samuelwg/LIFSrProj_W15/README.md

**Repository for Senior Project ECEn 490 Section 5, Winter 2015 Semester, BYU**
