samuelwg/LIFSrProj_W15/Analog/MATLAB Files/Matlab/2ndBoard/BPassZI.bmp

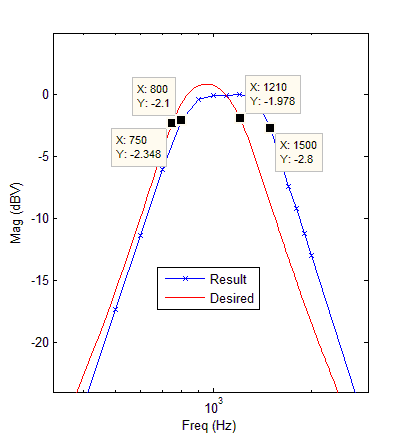
Analog/MATLAB Files/Matlab/2ndBoard/BPassZI.bmp
