samuelwg/LIFSrProj_W15/Analog/MATLAB Files/Matlab/2ndBoard/BPassZO.bmp

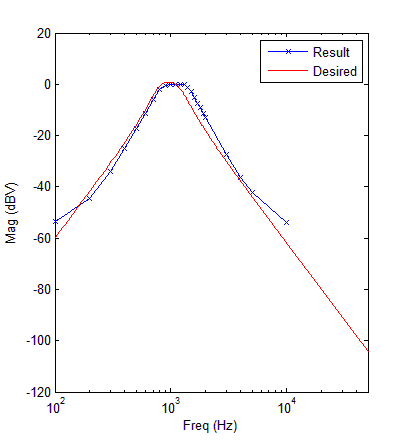
Analog/MATLAB Files/Matlab/2ndBoard/BPassZO.bmp
