samuelwg/LIFSrProj_W15/Analog/MATLAB Files/Matlab/2ndBoard/BPv2ZO.bmp

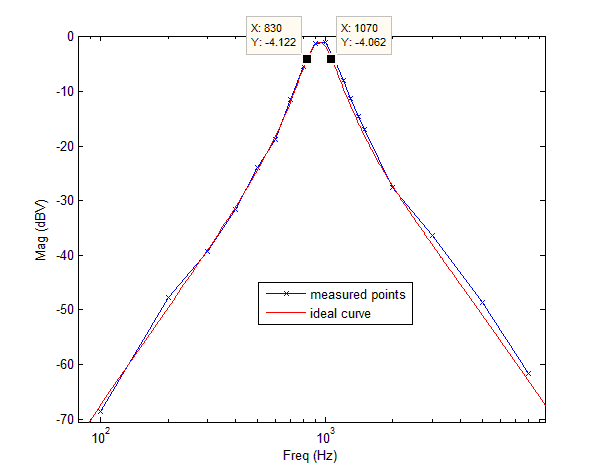
Analog/MATLAB Files/Matlab/2ndBoard/BPv2ZO.bmp
