samuelwg/LIFSrProj_W15/Analog/MATLAB Files/Matlab/2ndBoard/HighPassZI.bmp

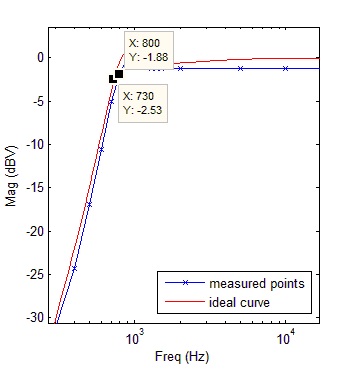
Analog/MATLAB Files/Matlab/2ndBoard/HighPassZI.bmp
