samuelwg/LIFSrProj_W15/Analog/MATLAB Files/Matlab/2ndBoard/HighPassZO.bmp

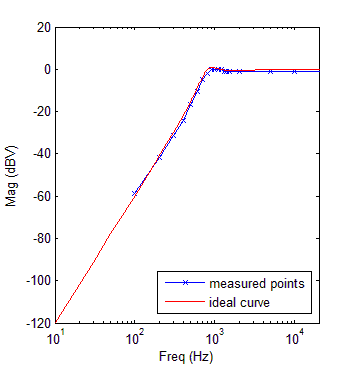
Analog/MATLAB Files/Matlab/2ndBoard/HighPassZO.bmp
