samuelwg/LIFSrProj_W15/Analog/MATLAB Files/Matlab/2ndBoard/LowPassZI.bmp

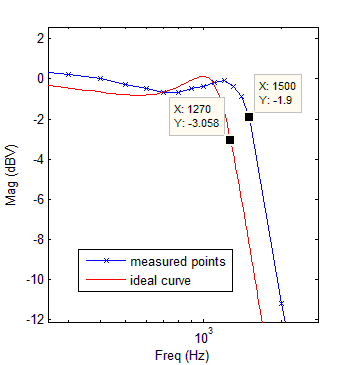
Analog/MATLAB Files/Matlab/2ndBoard/LowPassZI.bmp
