samuelwg/LIFSrProj_W15/Analog/MATLAB Files/Matlab/2ndBoard/LowPassZO.bmp

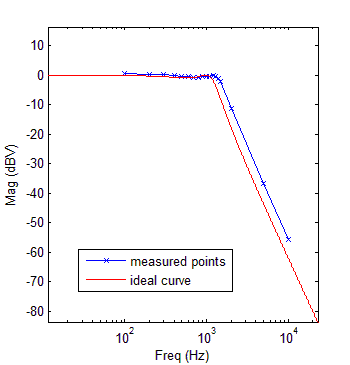
Analog/MATLAB Files/Matlab/2ndBoard/LowPassZO.bmp
