samuelwg/LIFSrProj_W15/Analog/Misc./Pictures/AmpBode.JPG

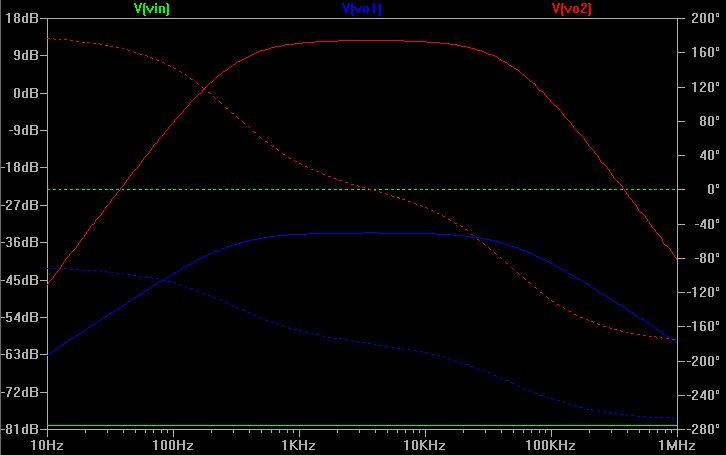
Analog/Misc./Pictures/AmpBode.JPG
