samuelwg/LIFSrProj_W15/Analog/Misc./Pictures/AmpSch.JPG

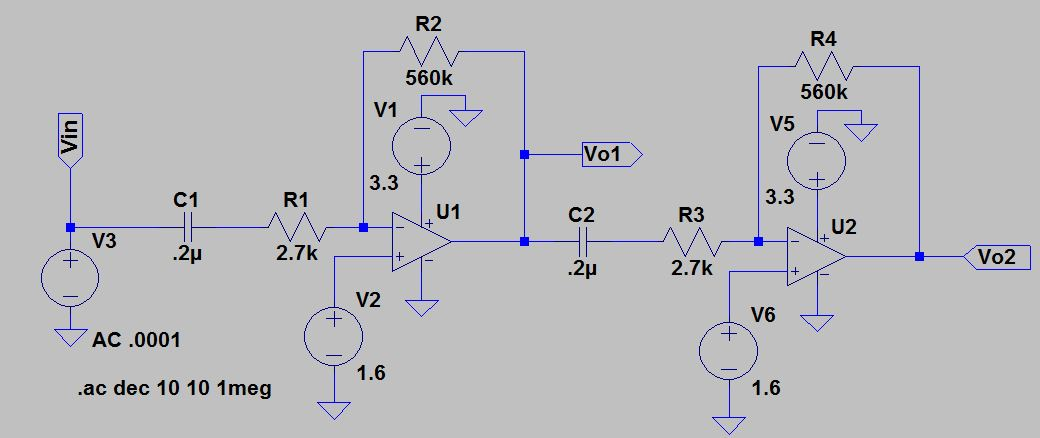
Analog/Misc./Pictures/AmpSch.JPG
