samuelwg/LIFSrProj_W15/Analog/Misc./Pictures/Design Pics/SallenBode.JPG

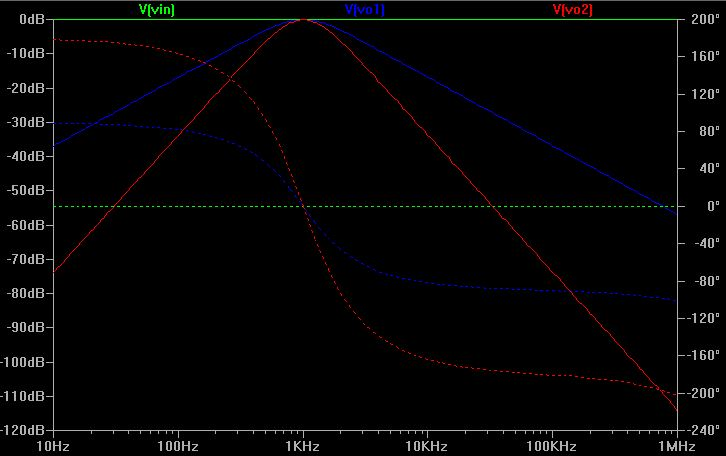
Analog/Misc./Pictures/Design Pics/SallenBode.JPG
