samuelwg/LIFSrProj_W15/Analog/Misc./Pictures/Design Pics/SallenSch.JPG

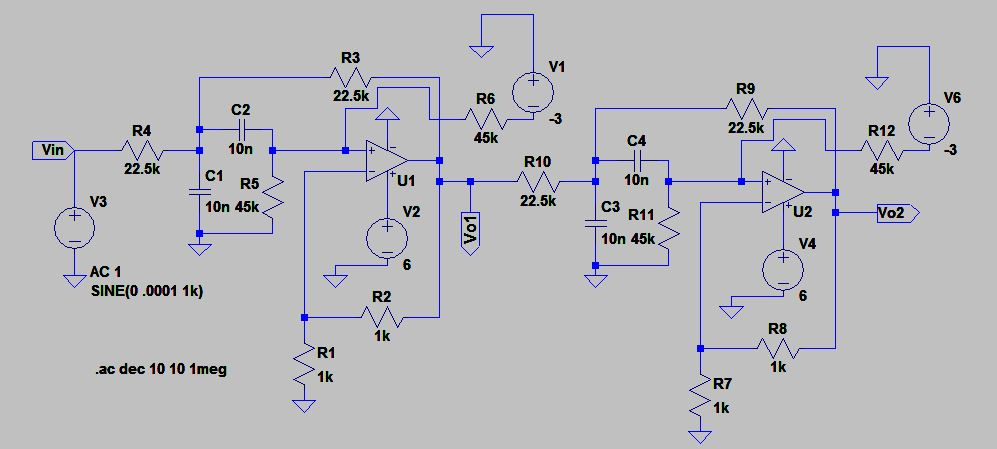
Analog/Misc./Pictures/Design Pics/SallenSch.JPG
