samuelwg/LIFSrProj_W15/Analog/Misc./Pictures/Design Pics/TotalBode.JPG

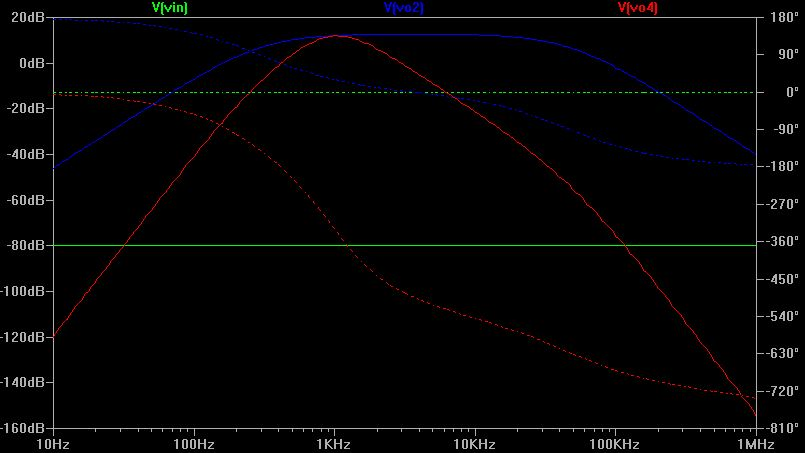
Analog/Misc./Pictures/Design Pics/TotalBode.JPG
