samuelwg/LIFSrProj_W15/Analog/Misc./Pictures/Design Pics/TotalSch.JPG

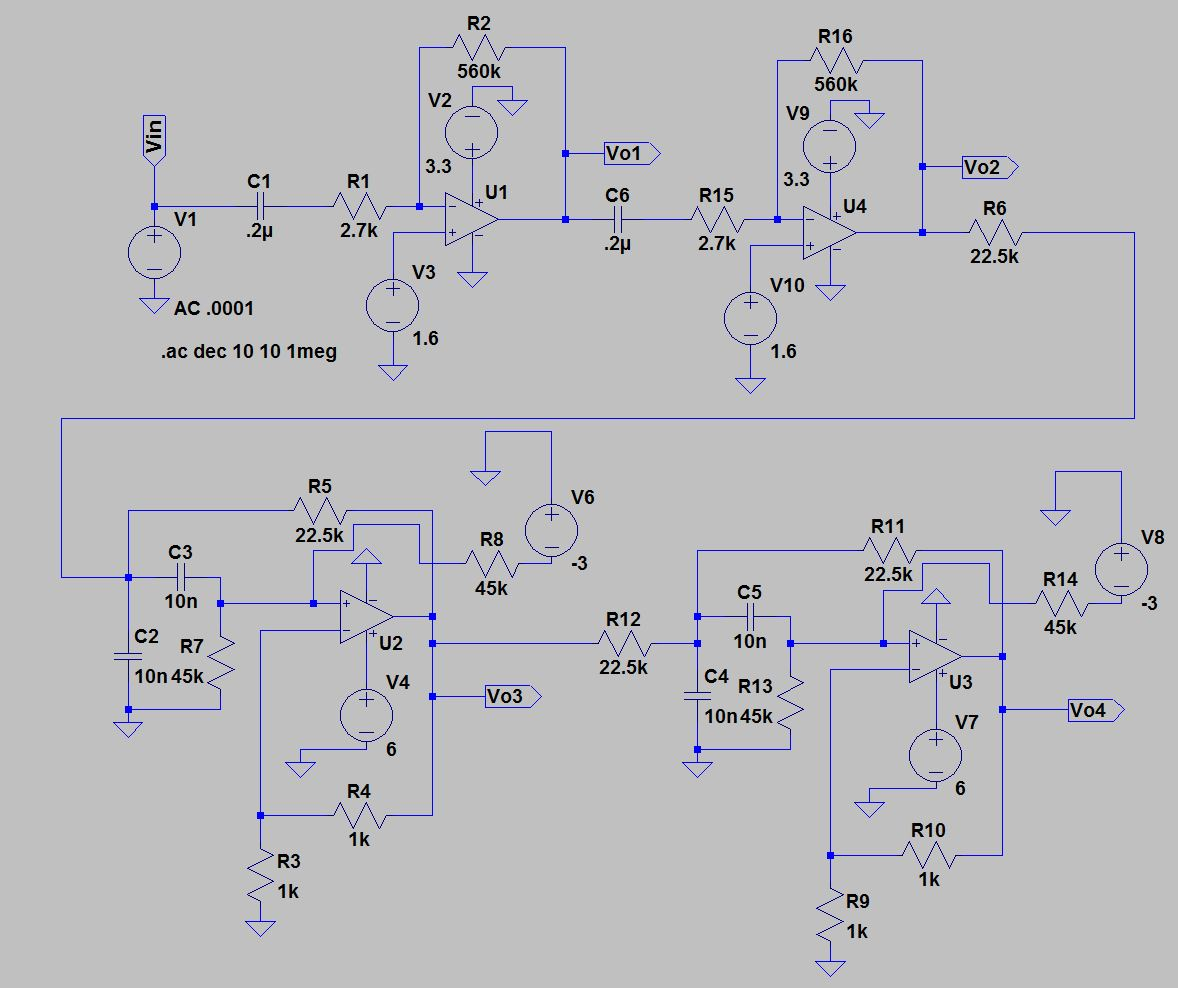
Analog/Misc./Pictures/Design Pics/TotalSch.JPG
