samuelwg/LIFSrProj_W15/XYZ_control/XYZ_board/XYZboard_BOM.xls

Reference | Value | Count | Cost/item | Cost/board | Name | Manufacture Part # | Digikey Part # | URL
C2, C4-C12, C16-21 | .1uF | 16 | 0.0956 | 1.5296 | CAP CER 0.1UF 100V 10% X7R 0603 | CC0603KRX7R0BB104 | 311-1523-1-ND | http://www.digikey.com/product-detail/en/CC0603KRX7R0BB104/311-1523-1-ND/3476112
C13-15 | .22uF | 3 | 0.11 | 0.33 | CAP CER 0.22UF 50V Y5V 0603 | CL10F224ZB8NNNC | 1276-2367-1-ND | http://www.digikey.com/product-detail/en/CL10F224ZB8NNNC/1276-2367-1-ND/3890453
C3 | 1uF | 1 | 0.1 | 0.1 | CAP CER 1UF 10V Y5V 0603 | CL10F105ZP8NNNC | 1276-1041-1-ND | http://www.digikey.com/product-detail/en/CL10F105ZP8NNNC/1276-1041-1-ND/3889127
C1 | 47uF | 1 | 0.64 | 0.64 | CAP ALUM 47UF 50V 20% SMD | EEE-1HA470XP | PCE3929CT-ND | http://www.digikey.com/product-detail/en/EEE-1HA470XP/PCE3929CT-ND/766305
D1 | Diode 3A | 1 | 0.55 | 0.55 | DIODE SCHOTTKY 3A 40V SMA | SD2010S040S3R0 | 478-7814-1-ND | http://www.digikey.com/product-detail/en/SD2010S040S3R0/478-7814-1-ND/3749535
LED1 | PWR LED | 1 | 0.08 | 0.08 | LED CHIPLED 570NM GREEN 0805 SMD | LG R971-KN-1 | 475-1410-1-ND | http://www.digikey.com/product-detail/en/LG%20R971-KN-1/475-1410-1-ND/1802598
J1, J10, J15 | DB9_connector | 3 | 0.77 | 2.31 | CONN D-SUB MALE 9POS R/A .318 | A-DS-09-A/KG-T2S | AE10968-ND | http://www.digikey.com/product-detail/en/A-DS-09-A%2FKG-T2S/AE10968-ND/1241804
J2-5, J9, J11-14 | 2 pin header | 9 |  | 0
J6, J7, J8 | 6 pin header | 3 |  | 0
RA1-6 | 20k x4 | 6 | 0.068 | 0.408 | RES ARRAY 20K OHM 4 RES 1206 | CAT16-203J4LF | CAT16-203J4LFCT-ND | http://www.digikey.com/product-detail/en/CAT16-203J4LF/CAT16-203J4LFCT-ND/3741147
R10-15 | 0.11 | 6 | 0.52 | 3.12 | RES SMD 0.11 OHM 1% 1/2W 1206 | 2-2176055-6 | A109646CT-ND | http://www.digikey.com/product-detail/en/2-2176055-6/A109646CT-ND/4032412
R16-18 | 20k | 3 | 0.04 | 0.12 | RES SMD 20K OHM 5% 1/10W 0603 | CRCW060320K0JNEA | 541-20KGCT-ND | http://www.digikey.com/product-detail/en/CRCW060320K0JNEA/541-20KGCT-ND/1179400
R19-21 | 2.49k | 3 | 0.22 | 0.66 | RES SMD 2.49K OHM 0.5% 1/10W | RT0603DRD072K49L | 311-2.49KDCT-ND | http://www.digikey.com/product-search/en?pv7=2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
R22-24 | 10k | 3 | 0.27 | 0.81 | TRIMMER 10K OHM 0.1W SMD | TC33X-2-103E | TC33X-103ECT-ND | http://www.digikey.com/product-detail/en/TC33X-2-103E/TC33X-103ECT-ND/612911
R1 | 240 | 1 | 0.1 | 0.1 | RES SMD 240 OHM 1% 1/10W 0603 | MCR03ERTF2400 | RHM240CFCT-ND | http://www.digikey.com/product-detail/en/MCR03ERTF2400/RHM240CFCT-ND/4098698
R3, R4-9 | 715 | 7 | 0.081 | 0.567 | RES SMD 715 OHM 1% 1/10W 0603 | CRCW0603715RFKEA | 541-715HCT-ND | http://www.digikey.com/product-detail/en/CRCW0603715RFKEA/541-715HCT-ND/1179793
R2 | 1k | 1 | 0.074 | 0.074 | RES SMD 1K OHM 5% 1/10W 0603 | CRCW06031K00JNEA | 541-1.0KGCT-ND | http://www.digikey.com/product-detail/en/CRCW06031K00JNEA/541-1.0KGCT-ND/1179369
U2,U3,U4 | A4988_stepper_driver | 3 | 2.941 | 8.823 | IC MOTOR DRIVER PAR 28QFN | A4988SETTR-T | 620-1343-1-ND | http://www.digikey.com/product-detail/en/A4988SETTR-T/620-1343-1-ND/2238004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
U1 | Voltage Regulator | 1 | 0.81 | 0.81 | IC REG LDO ADJ 0.5A SOT223 | LM317MSTT3G | LM317MSTT3GOSCT-ND | http://www.digikey.com/product-detail/en/LM317MSTT3G/LM317MSTT3GOSCT-ND/2120656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
 |  |  | Total: | 21.0316
