samuelwg/LIFSrProj_W15/CAD/Sample_Clamping_Mechcanism_CAD/SampleBase.stl

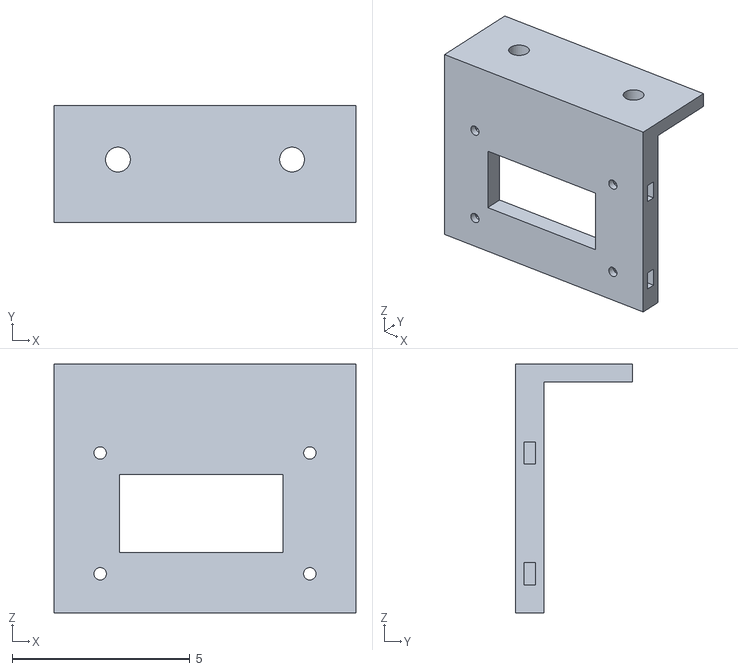
[picture p15: CAD file, 2015-02-27]
CAD/Sample_Clamping_Mechcanism_CAD/SampleBase.stl
8.50 x 3.30 x 7.00
