samuelwg/LIFSrProj_W15/CAD/Testing LED Optical Housing/Power_Meter_Adapter_Part1.stl

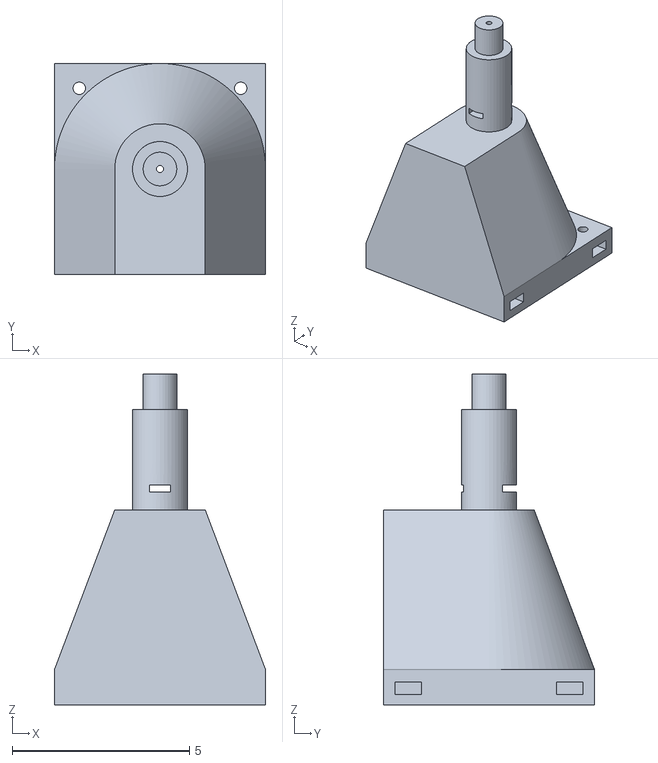
[picture p16: CAD file, 2015-02-27]
CAD/Testing LED Optical Housing/Power_Meter_Adapter_Part1.stl
5.95 x 5.95 x 9.33
