samuelwg/LIFSrProj_W15/Power Supply/Base.SLDPRT

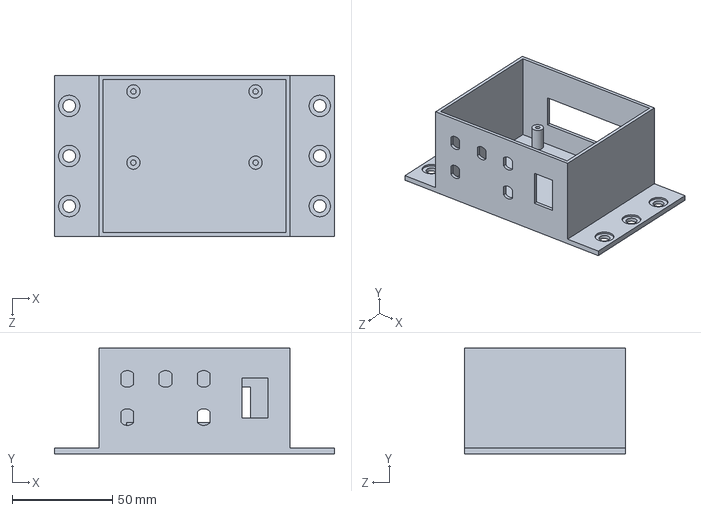
[picture p17: CAD file, 2015-02-27]
Power Supply/Base.SLDPRT
139.7 x 52.8 x 80.2 mm
