samuelwg/LIFSrProj_W15/CAD/Sample_Clamping_Mechcanism_CAD/SampleClampingSystem.stl

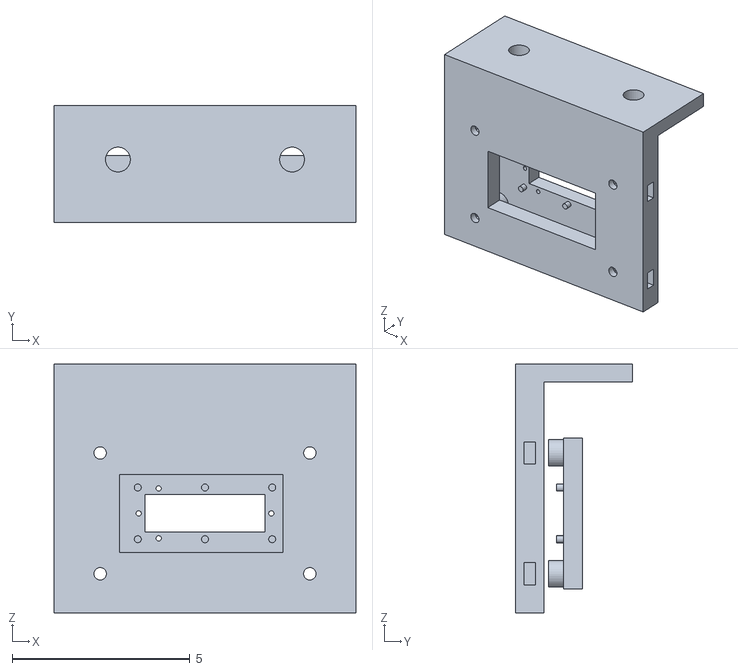
[picture p18: CAD file, 2015-02-27]
CAD/Sample_Clamping_Mechcanism_CAD/SampleClampingSystem.stl
8.50 x 3.30 x 7.00
