samuelwg/LIFSrProj_W15/CAD/Testing LED Optical Housing/Power_Meter_Adapter_Part2.stl

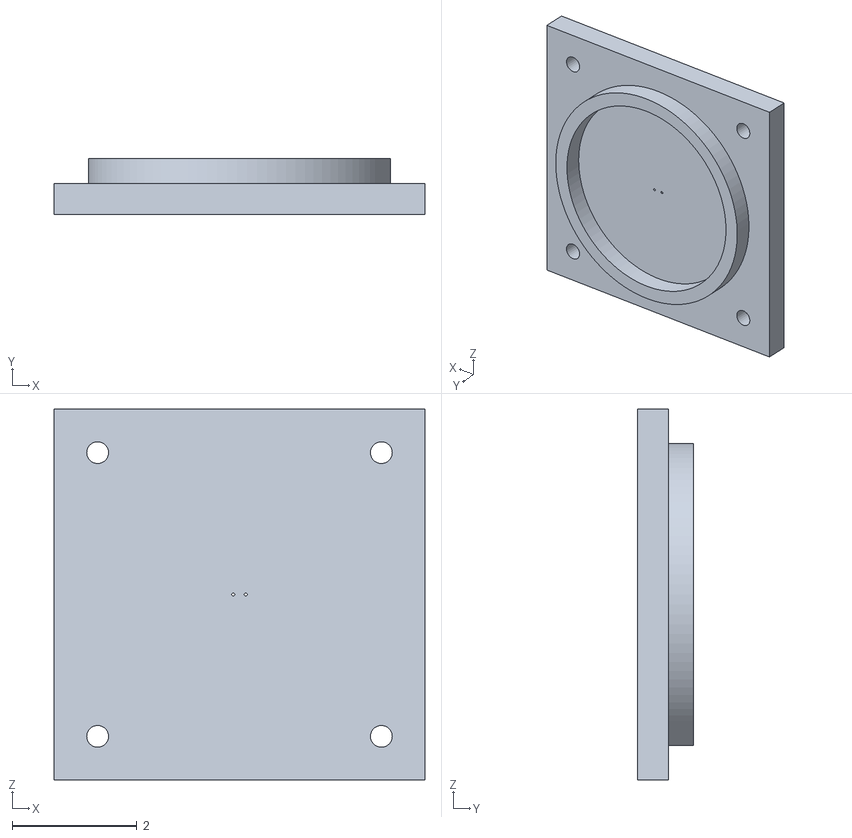
[picture p19: CAD file, 2015-02-27]
CAD/Testing LED Optical Housing/Power_Meter_Adapter_Part2.stl
5.95 x 0.9 x 5.95
