samuelwg/LIFSrProj_W15/CAD/Sample_Clamping_Mechcanism_CAD/490HV_MicrofluidicClamp.stl

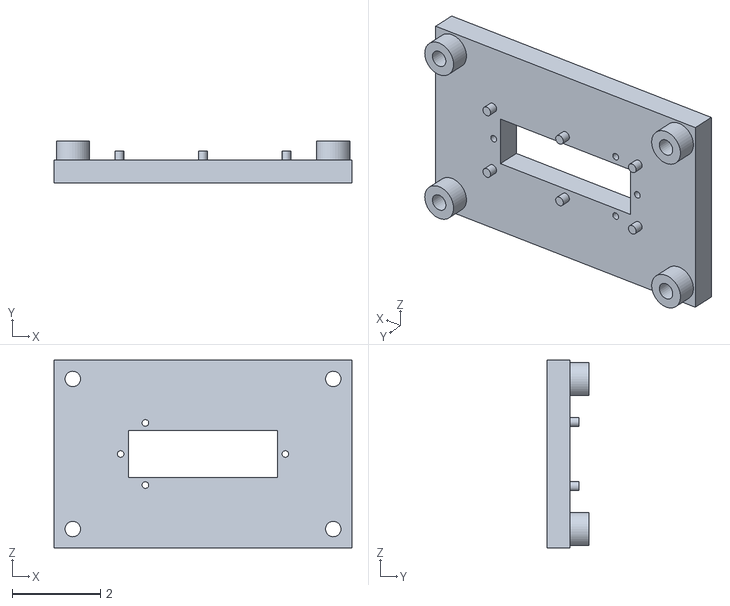
[picture p20: CAD file, 2015-02-27]
CAD/Sample_Clamping_Mechcanism_CAD/490HV_MicrofluidicClamp.stl
6.75 x 0.961 x 4.25
