samuelwg/LIFSrProj_W15/(list of files, cad)

Other CAD files:
CAD/Sample_Clamping_Mechcanism_CAD/490HV_MicrofluidicClamp.ipt
CAD/Sample_Clamping_Mechcanism_CAD/SampleBase.ipt
CAD/Sample_Clamping_Mechcanism_CAD/SampleClampingSystem.iam
CAD/Testing LED Optical Housing/OldVersions/Power_Meter_Adapter_Part1.0003.ipt
CAD/Testing LED Optical Housing/Power_Meter_Adapter_Part1.ipt
CAD/Testing LED Optical Housing/Power_Meter_Adapter_Part2.ipt
