samuelwg/LIFSrProj_W15/Analog/Misc./Pictures/New Design Testing/AmpBPGain.JPG

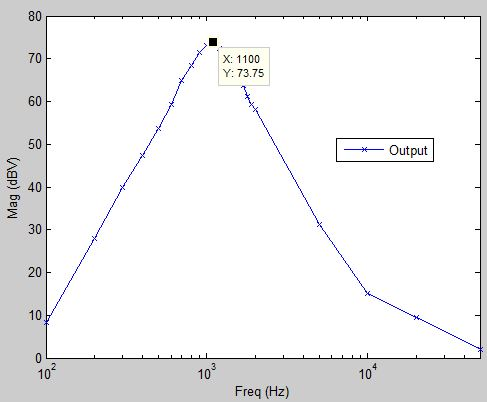
Analog/Misc./Pictures/New Design Testing/AmpBPGain.JPG
