samuelwg/LIFSrProj_W15/Analog/Misc./Pictures/New Design Testing/AmpBPZO.JPG

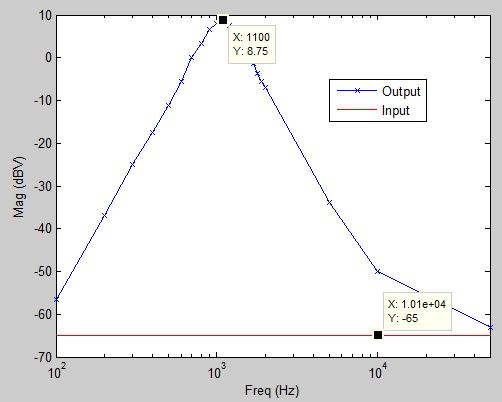
Analog/Misc./Pictures/New Design Testing/AmpBPZO.JPG
