samuelwg/LIFSrProj_W15/Analog/Misc./Pictures/New Design Testing/BP6ZO.JPG

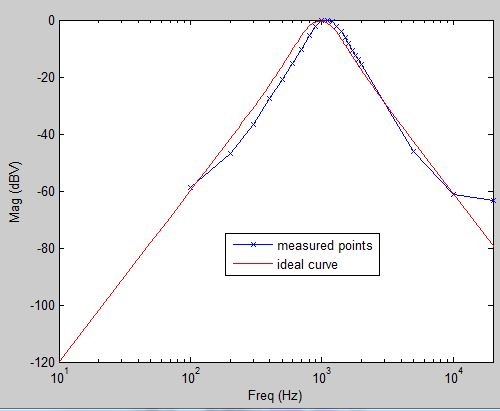
Analog/Misc./Pictures/New Design Testing/BP6ZO.JPG
