samuelwg/LIFSrProj_W15/Analog/Misc./Pictures/New Design Testing/FGOffOut.png

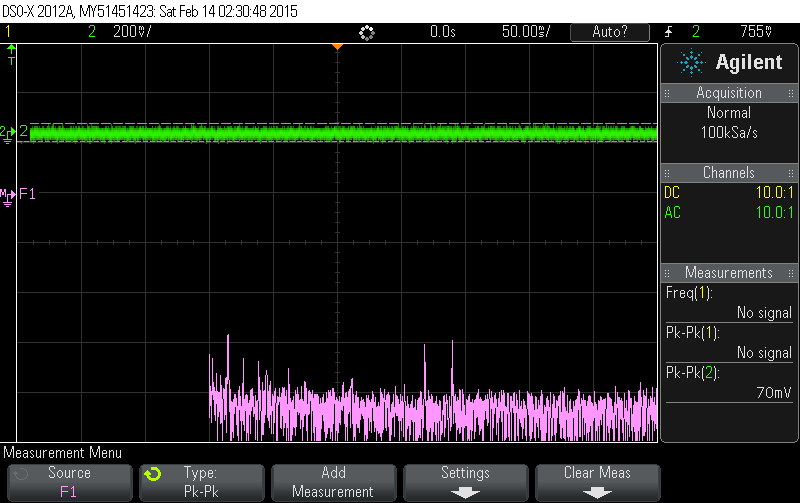
Analog/Misc./Pictures/New Design Testing/FGOffOut.png
