samuelwg/LIFSrProj_W15/Analog/Misc./Pictures/New Design Testing/FGOnOut_Time.png

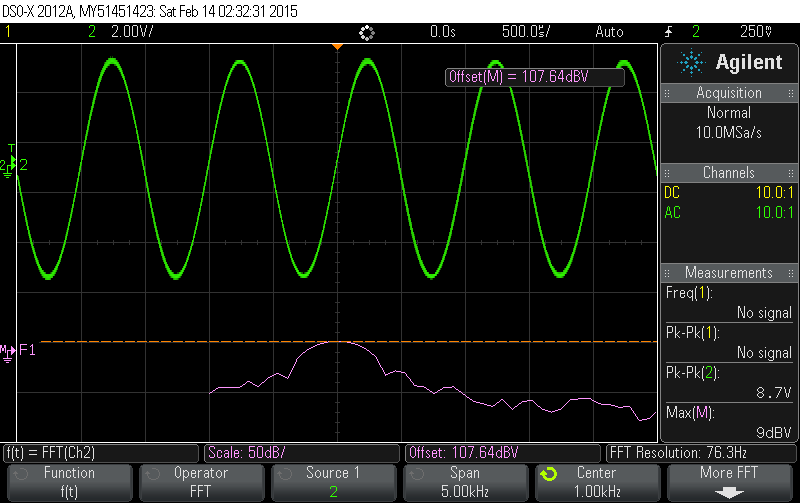
Analog/Misc./Pictures/New Design Testing/FGOnOut_Time.png
