samuelwg/LIFSrProj_W15/Analog/Misc./Pictures/New Design Testing/FloatingOut.png

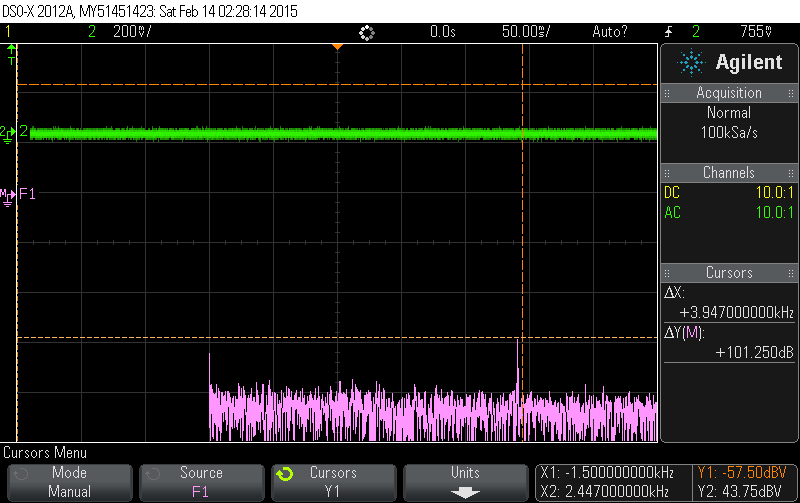
Analog/Misc./Pictures/New Design Testing/FloatingOut.png
