samuelwg/LIFSrProj_W15/Analog/Misc./Pictures/New Design Testing/GroundOut.png

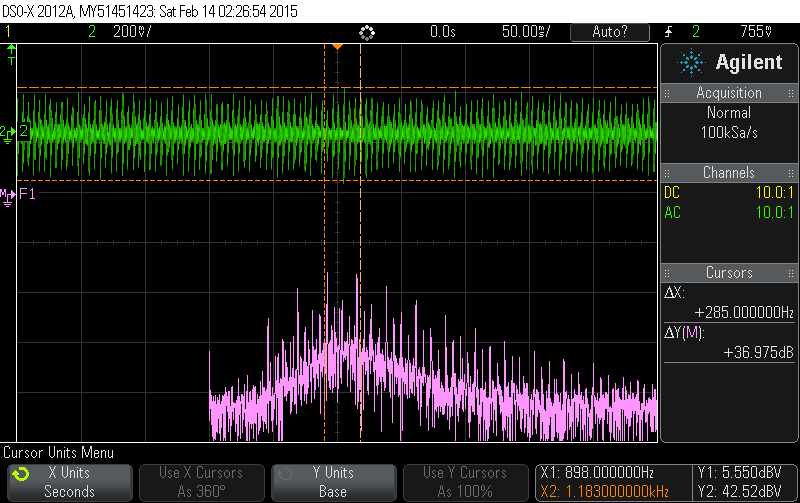
Analog/Misc./Pictures/New Design Testing/GroundOut.png
