samuelwg/LIFSrProj_W15/Analog/Misc./Pictures/New Design Testing/High3ZI.JPG

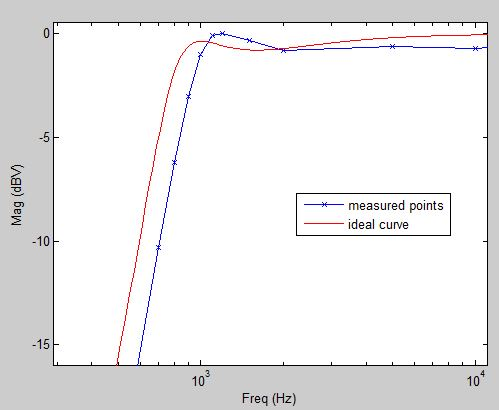
Analog/Misc./Pictures/New Design Testing/High3ZI.JPG
