samuelwg/LIFSrProj_W15/Analog/Misc./Pictures/New Design Testing/High3ZO.JPG

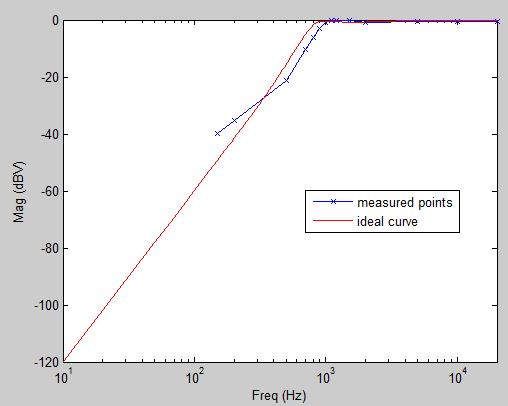
Analog/Misc./Pictures/New Design Testing/High3ZO.JPG
