samuelwg/LIFSrProj_W15/Analog/Misc./Pictures/New Design Testing/ResistorOut_Vpp.png

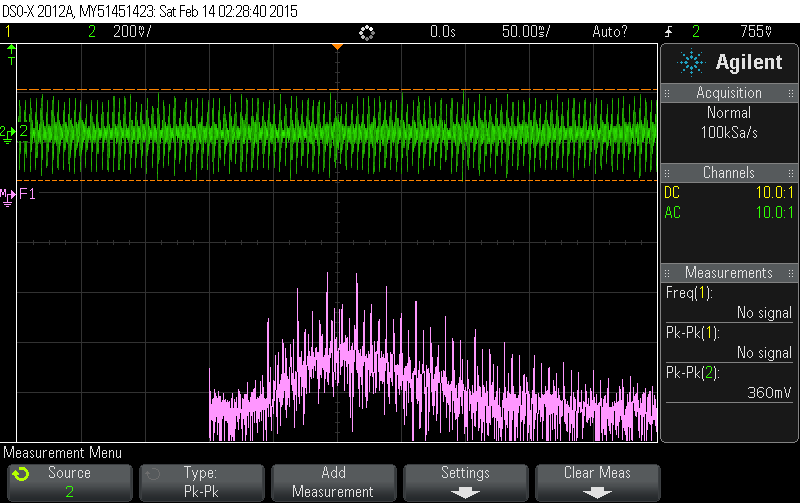
Analog/Misc./Pictures/New Design Testing/ResistorOut_Vpp.png
