samuelwg/LIFSrProj_W15/Analog/Misc./Pictures/PCB Testing/BodeZoomIn.JPG

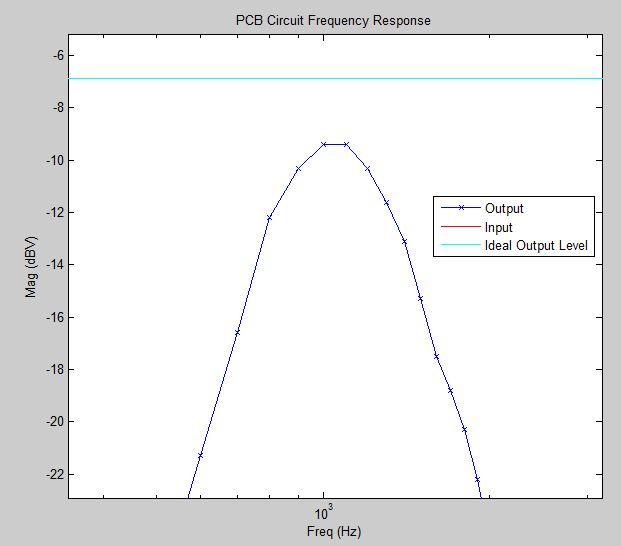
Analog/Misc./Pictures/PCB Testing/BodeZoomIn.JPG
