samuelwg/LIFSrProj_W15/Analog/Misc./Pictures/PCB Testing/BodeZoomOut.JPG

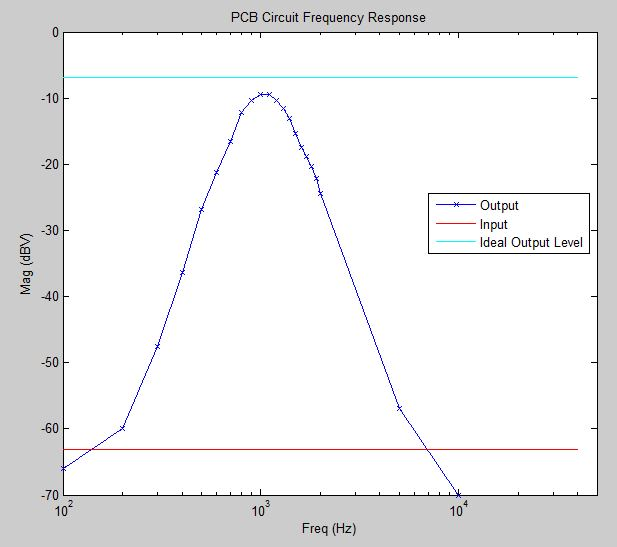
Analog/Misc./Pictures/PCB Testing/BodeZoomOut.JPG
