samuelwg/LIFSrProj_W15/Analog/LT Spice Schematics/2014F Amplifier Final Design.asc

C1: cap; 100n
C2: cap; 100n
C3: cap; 100n
C4: cap; 100n
C5: cap; 100n
C6: cap; 100n
R1: res; 4.19k
R2: res; 234
R3: res; 17.7k
R4: res; 2.8k
R5: res; 157
R6: res; 11.4k
R7: res; 3.42k
R8: res; 412
R9: res; 6.85k
R10: res; 20k
R11: res; 20k
R14: res; 1k
R15: res; 31.6k
R16: res; 1k
R17: res; 31.6k
U1: LT1211
U2: LT1211
U3: LT1211
U4: LT1211
U5: LT1211
U6: LT1211
V1: voltage; SINE(); AC 1
V2: voltage; 3
V3: voltage; 3
V4: voltage; 3
V5: voltage; 3
V6: voltage; 3
V7: voltage; 3
V8: voltage; 3
Named nets: 0, Vout
.ac dec 1001 1 1000meg
Fall 2014 Final Circuit Design
