samuelwg/LIFSrProj_W15/Analog/LT Spice Schematics/Winter 2015 Design/WholeSystem_v3.asc

C1: cap; 470p
C2: cap; .047µ
C3: cap; .022µ
C4: cap; .0033µ
C5: cap; .0033µ
C6: cap; .015µ
C7: cap; .2µ
R1: res; 1k
R2: res; 500
R3: res; 1k
R4: res; 1k
R5: res; 20k
R6: res; 1k
R7: res; 1k
R8: res; 1k
R9: res; 27k
R10: res; 100k
R11: res; 8.2k
R12: res; 660k
R13: res; 3.9k
R14: res; 8.2k
R15: res; 660k
U1: UniversalOpamp2
U2: UniversalOpamp2
U3: UniversalOpamp2
U4: UniversalOpamp2
V1: voltage; 12
V2: voltage; SINE(6 .01 1k); AC 1
V3: voltage; 12
V5: voltage; 12
V6: voltage; 12
Named nets: 0, Vin, A1, A2, Hp, Lp
.ac dec 100 100 1meg
The Lowpass Chebyshev design with cutoff = 950 Hz and ripple 2 dB.
Highpass design Chebyshev with cutoff 900 Hz and ripple 2.0 dB.
Winter 2015 Final Design
