samuelwg/LIFSrProj_W15/Analog/LT Spice Schematics/Winter 2015 Design/Amplifier.asc

R1: res; 1.01k
R2: res; 100k
R3: res; 1k
R4: res; 1k
R5: res; 100k
R6: res; 1k
R7: res; 1k
R8: res; 1k
U1: LT1677
U2: LT1677
V1: voltage; 3
V2: voltage; SINE(1.5 .1 1k); AC .00001
V3: voltage; 3
Named nets: 0
.tran 0 .1 .09 .01
