samuelwg/LIFSrProj_W15/Analog/LT Spice Schematics/Winter 2015 Design/SixthBP.asc

C1: cap; 470p
C2: cap; .022µ
C3: cap; .01µ
C4: cap; .0033µ
C5: cap; .0033µ
C6: cap; .022µ
R2: res; 33k
R3: res; 120k
R4: res; 11k
R5: res; 480k
R6: res; 4.7k
R7: res; 15k
R8: res; 480k
U2: UniversalOpamp2
U3: UniversalOpamp2
V3: voltage; ""; AC 1
V4: voltage; 10
V7: voltage; 10
Named nets: 0
.ac dec 50 10 1meg
