samuelwg/LIFSrProj_W15/Analog/LT Spice Schematics/Winter 2015 Design/SixthBPWider200.asc

C1: cap; 330p
C2: cap; .022µ
C3: cap; .01µ
C4: cap; .0047µ
C5: cap; .0047µ
C6: cap; .022µ
R1: res; 39k
R2: res; 120k
R3: res; 12k
R4: res; 440k
R5: res; 4.7k
R6: res; 8.2k
R7: res; 440k
U1: UniversalOpamp2
U2: UniversalOpamp2
V1: voltage; ""; AC 1
V2: voltage; 10
V3: voltage; 10
Named nets: 0
.ac dec 50 10 1meg
