samuelwg/LIFSrProj_W15/Analog/LT Spice Schematics/Winter 2015 Design/ThirdHigh.asc

C1: cap; .0033µ
C2: cap; .0033µ
C3: cap; .022µ
R1: res; 480k
R2: res; 4.7k
R3: res; 15k
R4: res; 480k
U1: UniversalOpamp2
V1: voltage; 0
V2: voltage; 10
V3: voltage; SINE(0 1 1k); AC 1
Named nets: 0
.ac dec 50 10 1meg
