samuelwg/LIFSrProj_W15/Analog/LT Spice Schematics/Winter 2015 Design/ThirdLow.asc

C1: cap; 470p
C2: cap; .022µ
C3: cap; .01µ
R1: res; 33k
R2: res; 120k
R3: res; 11k
U1: UniversalOpamp2
V1: voltage; SINE(5 1 1k); AC 1
V2: voltage; 10
V3: voltage; 0
Named nets: 0
.tran 0 .1 .09
