samuelwg/LIFSrProj_W15/Analog/AnalogReceiver_v2/KiCad/AmpFil/AmpFil.kicad_pcb

## KiCad design Analog/AnalogReceiver_v2/KiCad/AmpFil/AmpFil.kicad_pcb (2015-04-01)

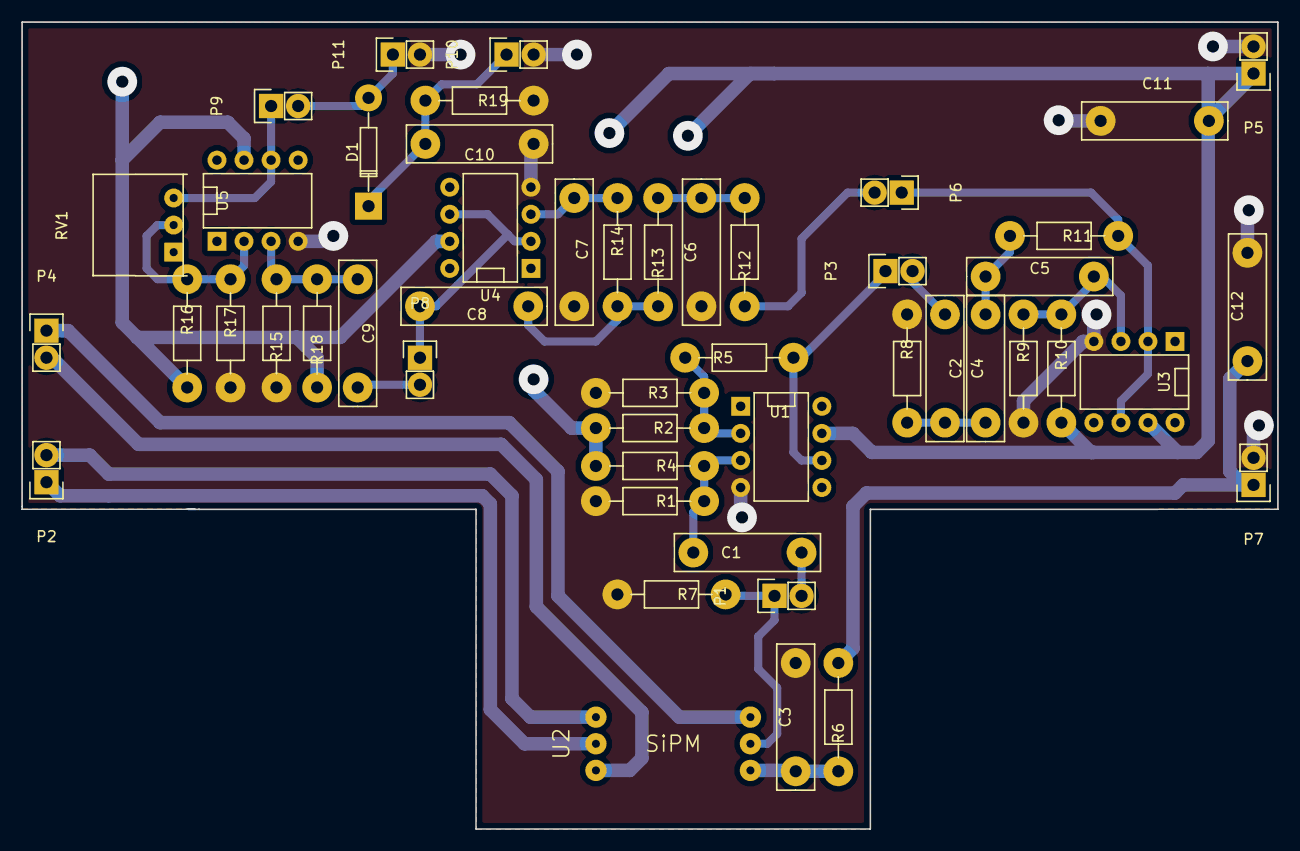
[picture p39: board Analog/AnalogReceiver_v2/KiCad/AmpFil/AmpFil.kicad_pcb from above]

Board: 2 copper layers, 117.9 x 75.7 mm, 49 parts (0 on the bottom side), 29 nets.

Parts:
C1, C9: .2u; Cap_Horizontal_Shop
C2, C6: 22n; Cap_Horizontal_Shop
C3, C8: 10n; Cap_Horizontal_Shop
C4, C5: 33n; Cap_Horizontal_Shop
C7: 470p; Cap_Horizontal_Shop
C10: 15n; Cap_Horizontal_Shop
C11, C12: 150u; Cap_Horizontal_Shop
D1: DIODE; Diode_Shop
P1, P2, P3, P4, P5, P6, P7, P8, P9, P10, P11: CONN_01X02; Pin_Header_1x02_Shop
R1, R4, R14, R15, R18: 33k; Resistor_Horizontal_Shop
R2, R3, R16, R17: 1k; Resistor_Horizontal_Shop
R5: 12k; Resistor_Horizontal_Shop
R6: 5.6k; Resistor_Horizontal_Shop
R7: 22k; Resistor_Horizontal_Shop
R8: 4.7k; Resistor_Horizontal_Shop
R9, R10: 480k; Resistor_Horizontal_Shop
R11: 15k; Resistor_Horizontal_Shop
R12: 11k; Resistor_Horizontal_Shop
R13: 120k; Resistor_Horizontal_Shop
R19: 1meg; Resistor_Horizontal_Shop
RV1: 100-100k; Potentiometer_Shop
U1, U3, U4, U5: LT1677; DIP-8__300_Shop
U2: SiPM

Connections:
29.7V: C12.2, P7.1, R6.1
+3.3VP: C11.2, P5.1, R2.2, R4.1, R10.2, R16.2, R18.1, U1.7, U3.7, U4.7, U5.7
/A1: P3.1, R5.1, U1.6
/A2: P9.1, RV1.3, U5.6
/F1: P6.1, R11.1, U3.2, U3.6
/F2: C8.1, P8.1, U4.2, U4.6
GND: C3.1, C6.1, C7.1, C10.2, C11.1, C12.1, P5.2, P7.2, P10.2, P11.2, R1.1, R3.2, R7.2, R8.2, R9.2, R15.1, R17.2, R19.2, U1.4, U3.4, U4.4, U5.4
unnamed: C1.1, R1.2, R4.2, U1.3
unnamed: C1.2, P1.2
unnamed: C2.1, C4.2, R8.1
unnamed: C2.2, P3.2
unnamed: C3.2, R6.2, U2.6
unnamed: C4.1, C5.2, R11.2
unnamed: C5.1, R9.1, R10.1, U3.3
unnamed: C6.2, R12.1, R13.2
unnamed: C7.2, R14.1, U4.3
unnamed: C8.2, R13.1, R14.2
unnamed: C9.1, R15.2, R18.2, U5.3
unnamed: C9.2, P8.2
unnamed: P2.1, U2.2
unnamed: P2.2, U2.1
unnamed: P6.2, R12.2
unnamed: R2.1, R3.1, R5.2, U1.2
unnamed: R16.1, R17.1, RV1.2, U5.2
ThR+: P4.1, U2.4
ThR-: P4.2, U2.3
Vin: P1.1, R7.1, U2.5
Vout: D1.1, P9.2, P11.1
Voutp: C10.1, D1.2, P10.1, R19.1
