samuelwg/LIFSrProj_W15/Analog/AnalogReceiver_v1/KiCad/AmpFil/AmpFil.kicad_pcb

## KiCad design Analog/AnalogReceiver_v1/KiCad/AmpFil/AmpFil.kicad_pcb (2015-03-16, an earlier design)

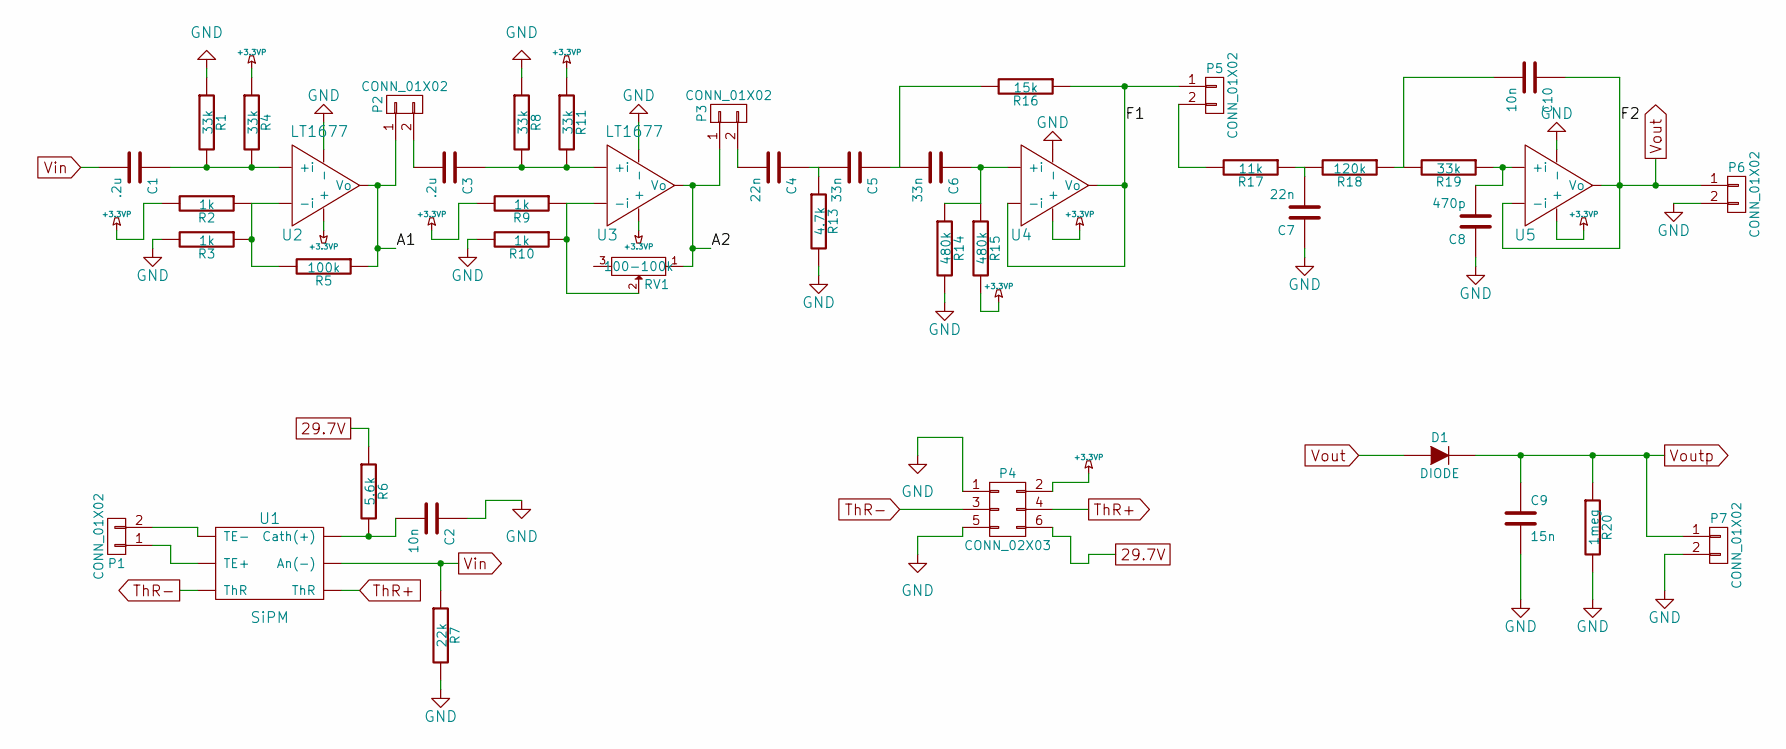
[picture p40: schematic AmpFil.sch]

Parts:
C1, C3: .2u; Capacitor13x4RM10
C2, C10: 10n; Capacitor13x4RM10
C4, C7: 22n; Capacitor13x4RM10
C5, C6: 33n; Capacitor13x4RM10
C8: 470p; Capacitor13x4RM10
C9: 15n; Capacitor13x4RM10
D1: DIODE; Diode_DO-35_SOD27_Horizontal_RM10
P1, P2, P3, P5: CONN_01X02; Pin_Header_Angled_2x01
P4: CONN_02X03; Pin_Header_Angled_2x03
P6, P7: CONN_01X02; Pin_Header_Angled_1x02
R1, R4, R8, R11, R19: 33k; Resistor_Horizontal_RM10mm
R2, R3, R9, R10: 1k; Resistor_Horizontal_RM10mm
R5: 100k; Resistor_Horizontal_RM10mm
R6: 5.6k; Resistor_Horizontal_RM10mm
R7: 22k; Resistor_Horizontal_RM10mm
R13: 4.7k; Resistor_Horizontal_RM10mm
R14, R15: 480k; Resistor_Horizontal_RM10mm
R16: 15k; Resistor_Horizontal_RM10mm
R17: 11k; Resistor_Horizontal_RM10mm
R18: 120k; Resistor_Horizontal_RM10mm
R20: 1meg; Resistor_Horizontal_RM10mm
RV1: 100-100k; Potentiometer_Trimmer-Suntan-TSR-3386C
U1: SiPM
U2, U3, U4, U5: LT1677; DIP-8__300

Connections:
29.7V: P4.6, R6.1
+3.3VP: P4.2, R2.2, R4.1, R9.2, R11.1, R15.2, U2.7 (+), U3.7 (+), U4.7 (+), U5.7 (+)
/A1: P2.1, R5.1, U2.6 (Vo)
/A2: P3.1, RV1.1, U3.6 (Vo)
/F1: P5.1, R16.1, U4.2 (-i), U4.6 (Vo)
GND: C2.1, C7.1, C8.1, C9.2, P4.1, P4.5, P6.2, P7.2, R1.1, R3.2, R7.2, R8.1, R10.2, R13.2, R14.2, R20.2, U2.4 (-), U3.4 (-), U4.4 (-), U5.4 (-)
unnamed: C1.1, R1.2, R4.2, U2.3 (+i)
unnamed: C2.2, R6.2, U1.6 (Cath(+))
unnamed: C3.1, R8.2, R11.2, U3.3 (+i)
unnamed: C3.2, P2.2
unnamed: C4.1, C5.2, R13.1
unnamed: C4.2, P3.2
unnamed: C5.1, C6.2, R16.2
unnamed: C6.1, R14.1, R15.1, U4.3 (+i)
unnamed: C7.2, R17.1, R18.2
unnamed: C8.2, R19.1, U5.3 (+i)
unnamed: C10.2, R18.1, R19.2
unnamed: P1.1, U1.2 (TE+)
unnamed: P1.2, U1.1 (TE-)
unnamed: P5.2, R17.2
unnamed: R2.1, R3.1, R5.2, U2.2 (-i)
unnamed: R9.1, R10.1, RV1.2, U3.2 (-i)
ThR+: P4.4, U1.4 (ThR)
ThR-: P4.3, U1.3 (ThR)
Vin: C1.2, R7.1, U1.5 (An(-))
Vout: C10.1, D1.1 (A), P6.1, U5.2 (-i), U5.6 (Vo)
Voutp: C9.1, D1.2 (K), P7.1, R20.1

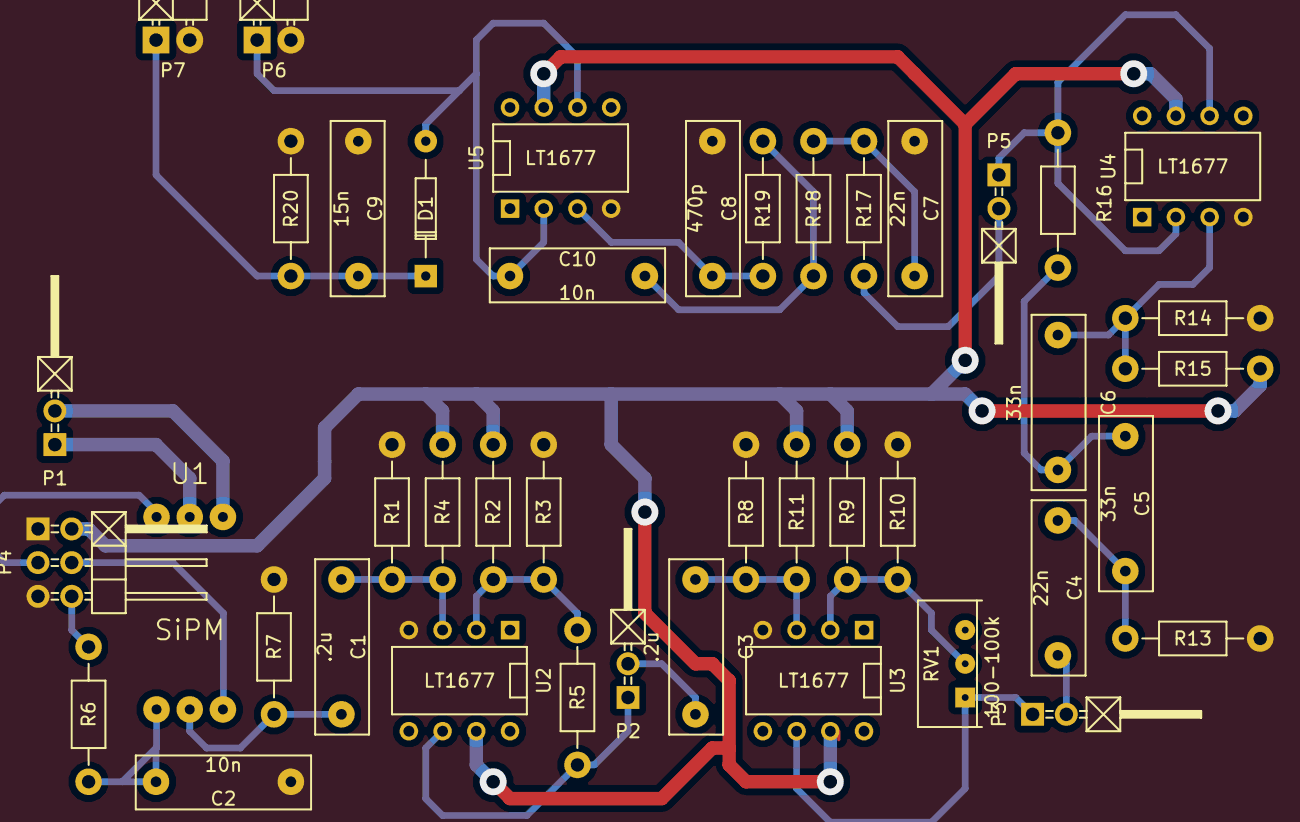
[picture p41: board Analog/AnalogReceiver_v1/KiCad/AmpFil/AmpFil.kicad_pcb from above]

Board: 2 copper layers, 43 parts (0 on the bottom side), 27 nets.
