samuelwg/LIFSrProj_W15/XYZ_control/XYZ_board/XYZboard.kicad_pcb

## KiCad design XYZ_control/XYZ_board/XYZboard.kicad_pcb (2015-02-27)

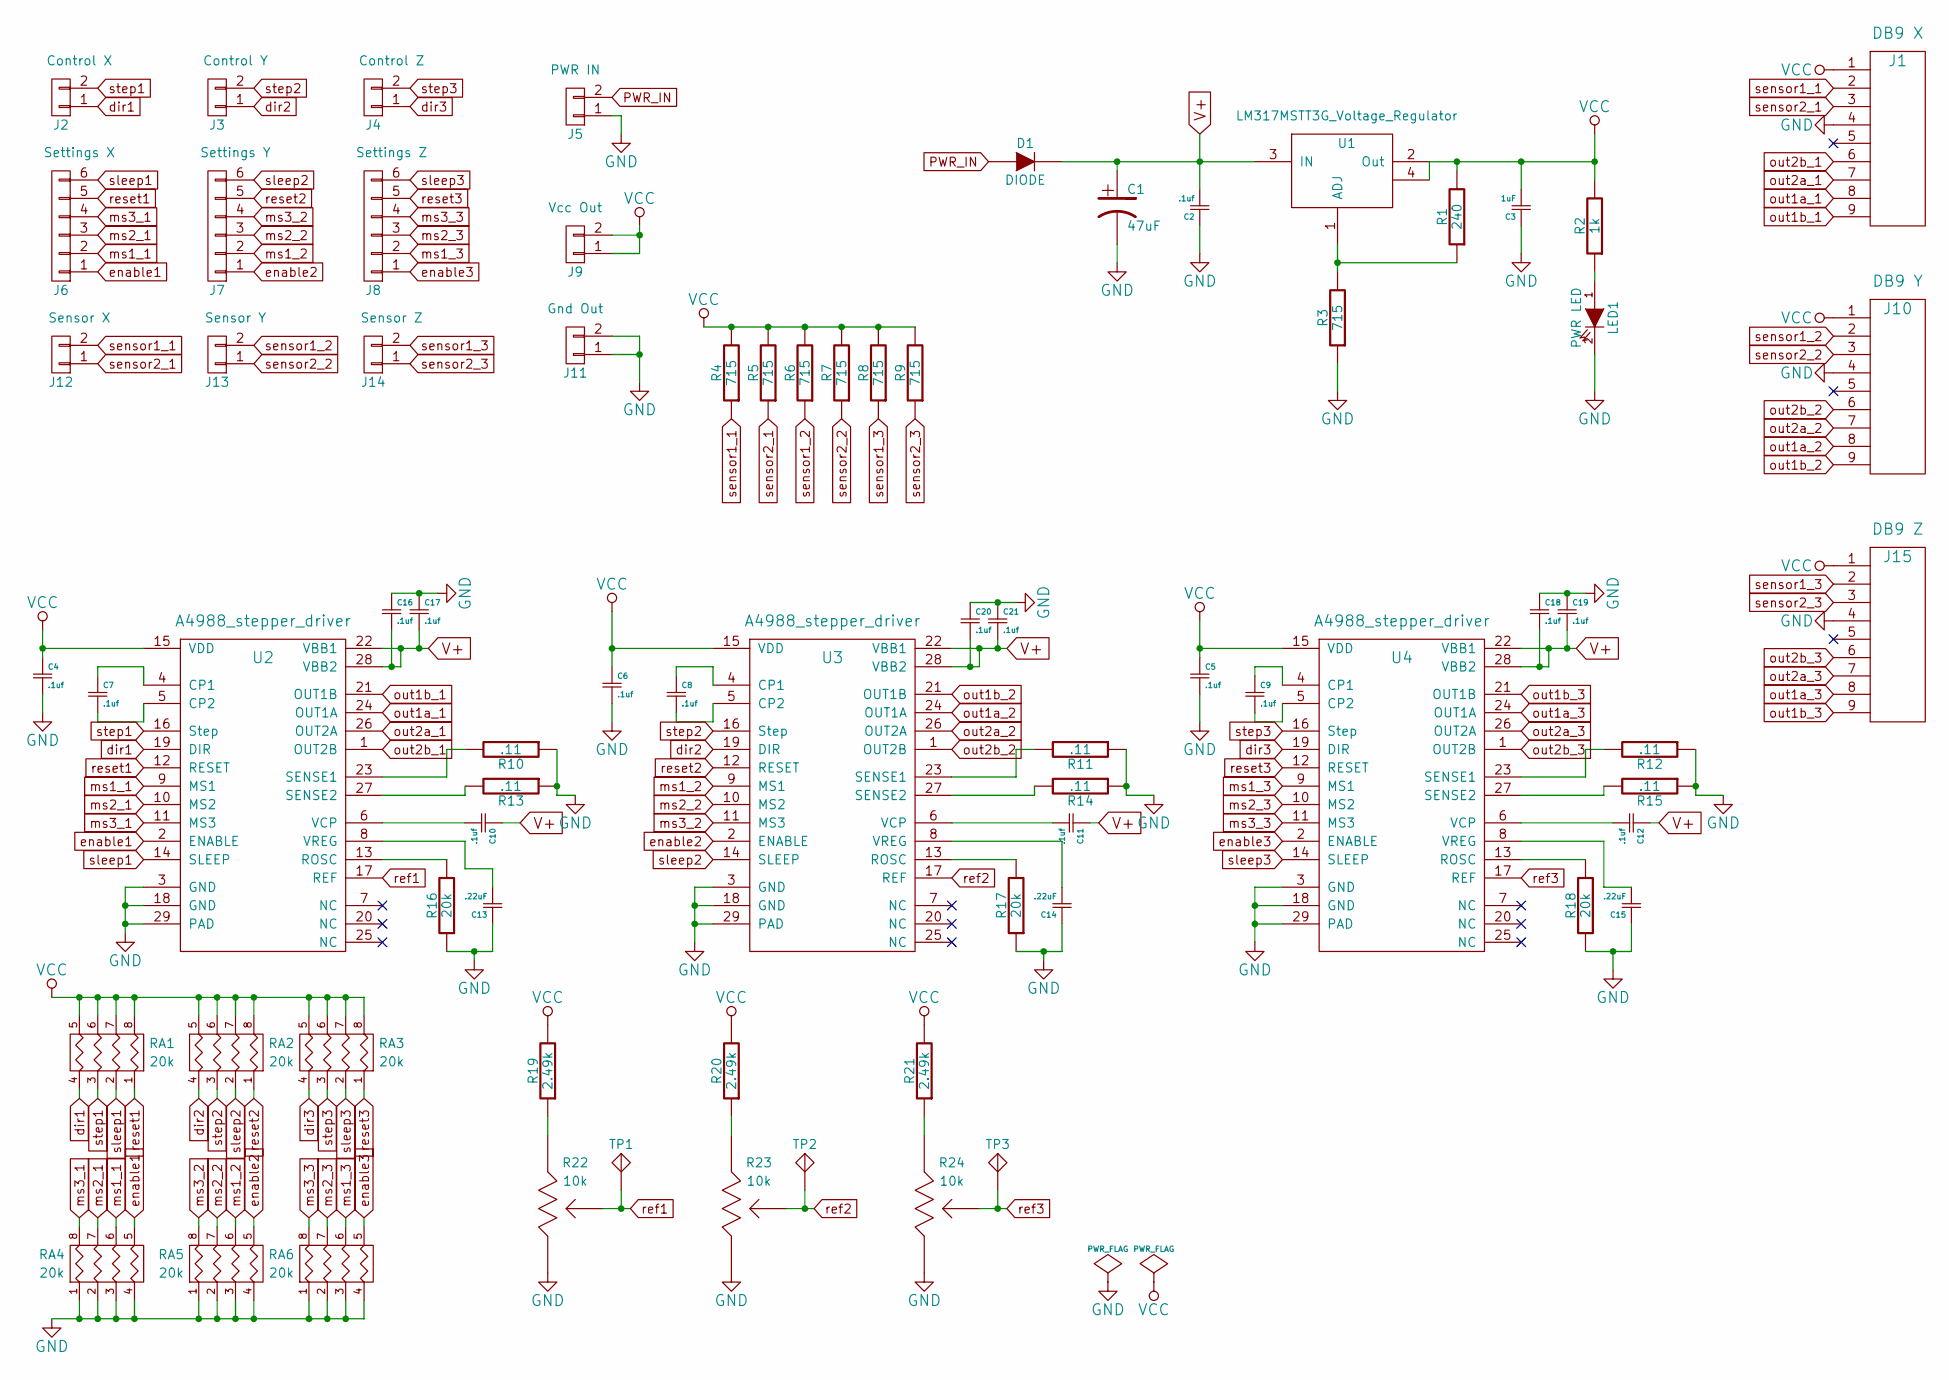
[picture p45: schematic XYZboard.sch]

Parts:
C1: 47uF; PCE3929CT-ND
C2, C4, C5, C6, C7, C8, C9, C10, C11, C12, C16, C17, C18, C19, C20, C21: .1uf; C_0603_HandSoldering
C3: 1uF; C_0603_HandSoldering
C13, C14, C15: .22uF; C_0603_HandSoldering
D1: DIODE; SD2010S040S3R0
J1: DB9 X; DB9MD
J2: Control X; Pin_Header_Straight_1x02
J3: Control Y; Pin_Header_Straight_1x02
J4: Control Z; Pin_Header_Straight_1x02
J5: PWR IN; Pin_Header_Straight_1x02
J6: Settings X; Pin_Header_Straight_1x06
J7: Settings Y; Pin_Header_Straight_1x06
J8: Settings Z; Pin_Header_Straight_1x06
J9: Vcc Out; Pin_Header_Straight_1x02
J10: DB9 Y; DB9MD
J11: Gnd Out; Pin_Header_Straight_1x02
J12: Sensor X; Pin_Header_Straight_1x02
J13: Sensor Y; Pin_Header_Straight_1x02
J14: Sensor Z; Pin_Header_Straight_1x02
J15: DB9 Z; DB9MD
LED1: PWR LED; LGR971-KN-1
R1: 240; R_0603_HandSoldering
R2: 1k; R_0603_HandSoldering
R3, R4, R5, R6, R7, R8, R9: 715; R_0603_HandSoldering
R10, R11, R12, R13, R14, R15: .11; R_1206_HandSoldering
R16, R17, R18: 20k; R_0603_HandSoldering
R19, R20, R21: 2.49k; R_0603_HandSoldering
R22, R23, R24: 10k; TC33X-103ECT-ND
RA1, RA2, RA3, RA4, RA5, RA6: 20k; CAT16-203J4LFCT-ND
TP1, TP2, TP3: Test_point; Measurement_Point_Square-SMD-Pad_Big
U1: LM317MSTT3G_Voltage_Regulator; voltage_regulator_sot223
U2, U3, U4: A4988_stepper_driver; Qfn_28_A4988_with_thermal_vias

Connections:
GND: C1.2, C2.1, C3.1, C4.2, C5.2, C6.2, C13.1, C14.1, C15.1, C16.1, C17.1, C18.1, C19.1, C20.1, C21.1, J1.4, J5.1, J10.4, J11.1, J11.2, J15.4, LED1.2 (K), R3.1, R10.1, R11.1, R12.1, R13.1, R14.1, R15.1, R16.1, R17.1, R18.1, R22.3, R23.3, R24.3, RA4.1, RA4.2, RA4.3, RA4.4, RA5.1, RA5.2, RA5.3, RA5.4, RA6.1, RA6.2, RA6.3, RA6.4, U2.3 (GND), U2.18 (GND), U2.29 (PAD), U3.3 (GND), U3.18 (GND), U3.29 (PAD), U4.3 (GND), U4.18 (GND), U4.29 (PAD)
unnamed: C7.1, U2.4 (CP1)
unnamed: C7.2, U2.5 (CP2)
unnamed: C8.1, U3.4 (CP1)
unnamed: C8.2, U3.5 (CP2)
unnamed: C9.1, U4.4 (CP1)
unnamed: C9.2, U4.5 (CP2)
unnamed: C10.2, U2.6 (VCP)
unnamed: C11.2, U3.6 (VCP)
unnamed: C12.2, U4.6 (VCP)
unnamed: C13.2, U2.8 (VREG)
unnamed: C14.2, U3.8 (VREG)
unnamed: C15.2, U4.8 (VREG)
unnamed: LED1.1 (A), R2.1
unnamed: R1.1, R3.2, U1.1 (ADJ)
unnamed: R10.2, U2.23 (SENSE1)
unnamed: R11.2, U3.23 (SENSE1)
unnamed: R12.2, U4.23 (SENSE1)
unnamed: R13.2, U2.27 (SENSE2)
unnamed: R14.2, U3.27 (SENSE2)
unnamed: R15.2, U4.27 (SENSE2)
unnamed: R16.2, U2.13 (ROSC)
unnamed: R17.2, U3.13 (ROSC)
unnamed: R18.2, U4.13 (ROSC)
unnamed: R19.1, R22.1
unnamed: R20.1, R23.1
unnamed: R21.1, R24.1
PWR_IN: D1.1 (A), J5.2
V+: C1.1, C2.2, C10.1, C11.1, C12.1, C16.2, C17.2, C18.2, C19.2, C20.2, C21.2, D1.2 (K), U1.3 (IN), U2.22 (VBB1), U2.28 (VBB2), U3.22 (VBB1), U3.28 (VBB2), U4.22 (VBB1), U4.28 (VBB2)
VCC: C3.2, C4.1, C5.1, C6.1, J1.1, J9.1, J9.2, J10.1, J15.1, R1.2, R2.2, R4.2, R5.2, R6.2, R7.2, R8.2, R9.2, R19.2, R20.2, R21.2, RA1.5 (R4), RA1.6 (R3), RA1.7 (R2), RA1.8 (R1), RA2.5 (R4), RA2.6 (R3), RA2.7 (R2), RA2.8 (R1), RA3.5 (R4), RA3.6 (R3), RA3.7 (R2), RA3.8 (R1), U1.2 (Out), U1.4, U2.15 (VDD), U3.15 (VDD), U4.15 (VDD)
dir1: J2.1, RA1.4, U2.19 (DIR)
dir2: J3.1, RA2.4, U3.19 (DIR)
dir3: J4.1, RA3.4, U4.19 (DIR)
enable1: J6.1, RA4.5 (R4), U2.2 (ENABLE)
enable2: J7.1, RA5.5 (R4), U3.2 (ENABLE)
enable3: J8.1, RA6.5 (R4), U4.2 (ENABLE)
ms1_1: J6.2, RA4.6 (R3), U2.9 (MS1)
ms1_2: J7.2, RA5.6 (R3), U3.9 (MS1)
ms1_3: J8.2, RA6.6 (R3), U4.9 (MS1)
ms2_1: J6.3, RA4.7 (R2), U2.10 (MS2)
ms2_2: J7.3, RA5.7 (R2), U3.10 (MS2)
ms2_3: J8.3, RA6.7 (R2), U4.10 (MS2)
ms3_1: J6.4, RA4.8 (R1), U2.11 (MS3)
ms3_2: J7.4, RA5.8 (R1), U3.11 (MS3)
ms3_3: J8.4, RA6.8 (R1), U4.11 (MS3)
out1a_1: J1.8, U2.24 (OUT1A)
out1a_2: J10.8, U3.24 (OUT1A)
out1a_3: J15.8, U4.24 (OUT1A)
out1b_1: J1.9, U2.21 (OUT1B)
out1b_2: J10.9, U3.21 (OUT1B)
out1b_3: J15.9, U4.21 (OUT1B)
out2a_1: J1.7, U2.26 (OUT2A)
out2a_2: J10.7, U3.26 (OUT2A)
out2a_3: J15.7, U4.26 (OUT2A)
out2b_1: J1.6, U2.1 (OUT2B)
out2b_2: J10.6, U3.1 (OUT2B)
out2b_3: J15.6, U4.1 (OUT2B)
ref1: R22.2, TP1.1, U2.17 (REF)
ref2: R23.2, TP2.1, U3.17 (REF)
ref3: R24.2, TP3.1, U4.17 (REF)
reset1: J6.5, RA1.1, U2.12 (RESET)
reset2: J7.5, RA2.1, U3.12 (RESET)
reset3: J8.5, RA3.1, U4.12 (RESET)
sensor1_1: J1.2, J12.2, R4.1
sensor1_2: J10.2, J13.2, R6.1
sensor1_3: J14.2, J15.2, R8.1
sensor2_1: J1.3, J12.1, R5.1
sensor2_2: J10.3, J13.1, R7.1
sensor2_3: J14.1, J15.3, R9.1
sleep1: J6.6, RA1.2, U2.14 (SLEEP)
sleep2: J7.6, RA2.2, U3.14 (SLEEP)
sleep3: J8.6, RA3.2, U4.14 (SLEEP)
step1: J2.2, RA1.3, U2.16 (Step)
step2: J3.2, RA2.3, U3.16 (Step)
step3: J4.2, RA3.3, U4.16 (Step)

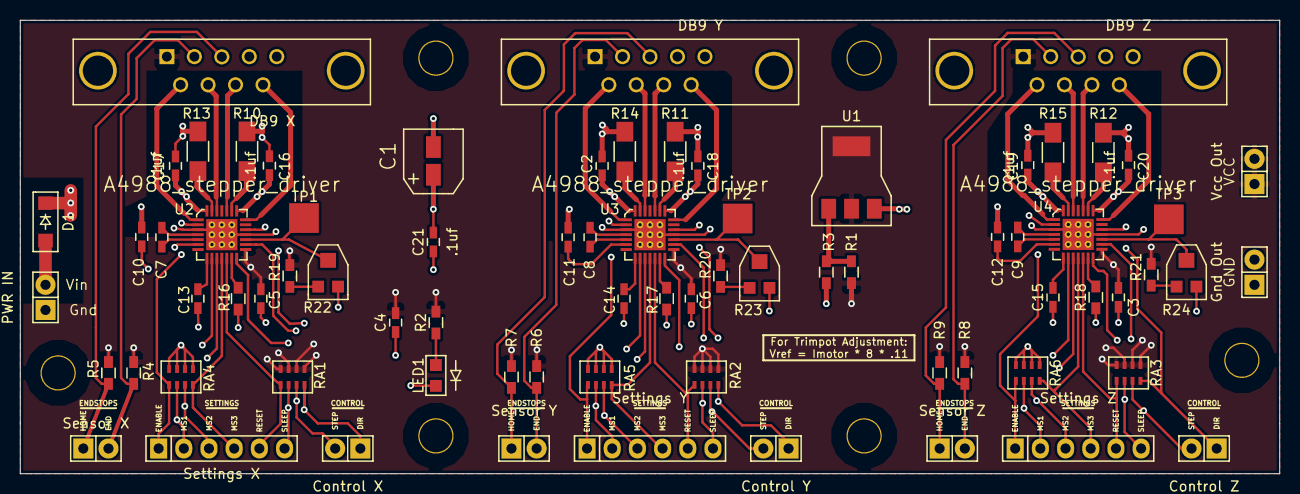
[picture p46: board XYZboard.kicad_pcb from above]

Board: 4 copper layers, 127.0 x 45.7 mm, 81 parts (0 on the bottom side), 75 nets.

Other parts of the board:
mounting hole0_13, mounting hole0_13#2, mounting hole0_13#3, mounting hole0_13#4, mounting hole0_13#5, mounting hole0_13#6: VAL**; mounting_hole_0_13_in
