samuelwg/LIFSrProj_W15/(commit log)

2015-01-26 Adding XYZ motor control board design
    [XYZboard.sch]
2015-01-27 Updated motor control board
    Added pull up resistors for the hall effect sensors
    [XYZboard.sch]
2015-01-27 updated motor control footprints
2015-01-28 Added pcb file and footprint lib
    [XYZboard.kicad_pcb]
2015-01-28 Added footprints
    added footprints for db9 connector and the qfn stepper driver
2015-01-28 Added Schematic
    I added a schematic and folder for the analog filter portion of the
    project.
2015-01-31 updated resistor values
    [XYZboard.sch]
2015-01-31 Updated parts on board
    [XYZboard.sch, XYZboard_BOM.csv]
2015-01-31 updated the bill of materials
    [XYZboard_BOM.csv, XYZboard_BOM.xlsx]
2015-02-01 updated BOM
    [XYZboard_BOM.xlsx]
2015-02-03 voltage regulator footprint and association
2015-02-03 board update
2015-02-06 Schematics
    With this commit I’ve added all the circuit schematics made up to this
    point. This is mainly just the schematic files for the amplifier/filter
    circuit.
2015-02-07 Adjusted pinout to processor
    rearranged pinout for pins to processor. Removed individual grounds for
    each set. Added vcc and gnd out
    [XYZboard.sch]
2015-02-07 Replaced pull-up and pull-down
    Replaced 20k pull up and pull down resistors with resistor arrays. Also
    reannotated the board and updated the BOM
    [XYZboard.sch, XYZboard_BOM.xls, XYZboard_BOM.xlsx]
2015-02-07 Started board layout
    [XYZboard.sch, XYZboard_BOM.xls]
2015-02-09 added Arduino receiver
2015-02-11 KiCad Schematics Upload
    This is just the KiCad files that I’m uploading right now.
    [AmpFil.sch]
2015-02-11 debuged arduino reciever
2015-02-13 Added code for PWM on the Teensy
2015-02-14 xyz board progress
    [XYZboard.kicad_pcb, XYZboard.sch]
2015-02-16 Current Clamping Design
    Printed and tested. Works!
    [490HV_MicrofluidicClamp.ipt, 490HV_MicrofluidicClamp.stl, SampleBase.ipt, SampleBase.stl, SampleClampingSystem.iam, SampleClampingSystem.stl]
2015-02-20 Modified Testing Adapter
    Still unprinted or tested
    [Power_Meter_Adapter_Part1.ipt, Power_Meter_Adapter_Part2.ipt]
2015-02-20 Parts and STL Files
    No new changes
    [Power_Meter_Adapter_Part1.0003.ipt, Power_Meter_Adapter_Part1.ipt, Power_Meter_Adapter_Part1.stl, Power_Meter_Adapter_Part2.stl]
2015-02-20 Added TeensyUI
2015-02-20 Updated the board and added output files
    [XYZboard-B_Cu.gbl, XYZboard-B_Mask.gbs, XYZboard-B_Paste.gbp, XYZboard-B_SilkS.gbo, XYZboard-Edge_Cuts.gbr, XYZboard-F_Cu.gtl, XYZboard-F_Mask.gts, XYZboard-F_Paste.gtp]
2015-02-21 New Work on PCB
    I did a lot of work and development on the PCB for the
    amplifier/filter. There should be a bunch of new files and
    modifications.
    [AmpFil.kicad_pcb, AmpFil.sch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]
2015-02-21 Added Power Supply housing model
    [Base.SLDPRT]
2015-02-23 Last changes
    I made some last changes to the PCB, mainly bias.
    [AmpFil.kicad_pcb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]
2015-02-23 Deleted Files
    I removed files to help maybe fix a problem with Github syncing.
    [AmpFil.kicad_pcb, AmpFil.sch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]
2015-02-23 Re-added Files
    I re-added the files to hopefully get everything up and bypass the
    syncing problem I was having.
    [AmpFil.kicad_pcb, AmpFil.sch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]
2015-02-23 Update on Teensy PWM control
2015-02-24 Minor changes to fit actual ND Filter
    This is what was printed
    [490HV_MicrofluidicClamp.ipt, 490HV_MicrofluidicClamp.stl, Power_Meter_Adapter_Part1.0003.ipt, Power_Meter_Adapter_Part1.ipt, Power_Meter_Adapter_Part1.stl, Power_Meter_Adapter_Part2.ipt, Power_Meter_Adapter_Part2.stl, SampleBase.ipt]
2015-02-27 Teensy footprint, schematic for HV system
    [Parent Folder.sch]
2015-02-27 Testing 2/27/2015
    [Parent Folder.sch]
2015-03-02 Updated TeensyUI
2015-03-02 Added .ino file to Teensy Data
2015-03-02 Added sample output file to TeensyUI
2015-03-04 Updated TeensyUI Files
2015-03-13 Loading characterization & other comments
    [Parent Folder.sch]
2015-03-13 Characterized flowing configuration
2015-03-13 actually pwm1
2015-03-16 Some Changes
    I made some minor changes.
    [AmpFil.kicad_pcb]
2015-03-16 Updated Teensy Files
2015-03-18 High voltage schematic changes
    [Parent Folder.sch]
2015-03-18 Updating My Work
    I’ve done a lot of work with making a new filter board. It’s all here.
    [AmpFil.kicad_pcb, AmpFil.sch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]
2015-03-25 teensyui update
2015-03-25 HV schematic and layout
    [Parent Folder.kicad_pcb, Parent Folder.sch]
2015-03-25 New Cutoffs
    I tweaked the designs to give different cutoff frequencies and ripple
    levels.
    [AmpFil.kicad_pcb, AmpFil.sch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]
2015-03-26 Made a few changes to the board. I think it's ready to be milled
    [Parent Folder.kicad_pcb, Parent Folder.sch]
2015-03-27 Updated teensy python code
2015-03-27 Files Made
    I made some files in trying to export this Kicad stuff to Eagle.
    [Parent Folder-B_Cu.gbl, Parent Folder-B_Cu.gbr, Parent Folder-Edge_Cuts.gbr, Parent Folder.drl]
2015-03-29 More teensy python changes
2015-03-30 Additional changes to the board, drill files, etc
    [Parent Folder.kicad_pcb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]
2015-04-01 Updated teensy code, added recorded data plotter
2015-04-10 Updating Files
    Making sure all files are up to date for the project documentation.
    [AmpFil.kicad_pcb, AmpFil.sch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]
2015-04-15 Uploading Files
    I’ve uploaded files that were important to testing the board.
